gabrielfbdiniz/BMS-Master-STM32-Nucleo-G474RE/README.md

# BMS Master — STM32 Nucleo G474RE (Formula ITA)
### ECU Central de Gerenciamento do Acumulador de Tração (20s18p)

Repositório oficial e unificado (**Monorepo**) de **Hardware**, **Firmware** e **Documentação de Engenharia** do BMS Master desenvolvido para o protótipo Formula SAE Electric da equipe **Formula ITA** (Temporada 2025-2026).

---

## Renderização 3D da Carrier Board

A placa **BMS Master Carrier Shield** é uma PCB de 4 camadas projetada para acoplar o núcleo de processamento **ST NUCLEO-G474RE** via conectores Morpho, integrando circuitos de proteção automotiva, barreira galvânica e interface com o circuito de segurança (SDC).

<div align="center">
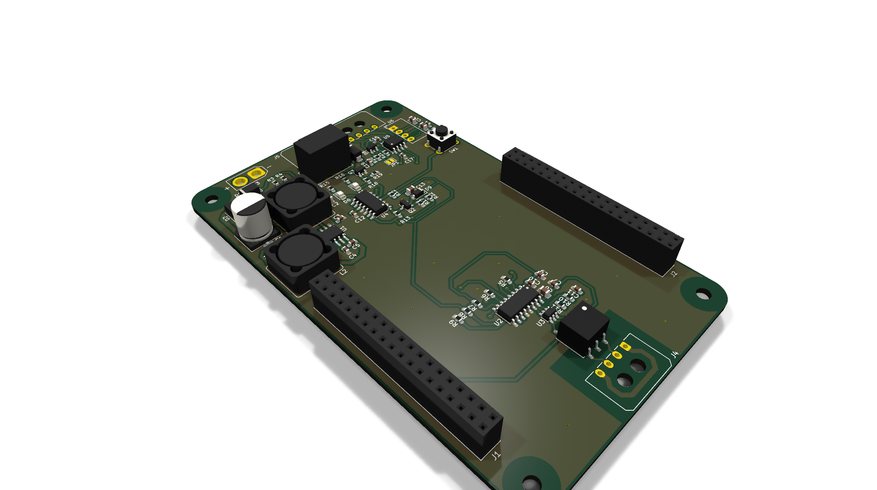
[picture p1: renders/master_render_iso_top.png]
BMS Master Carrier Shield - Perspectiva Superior
  
  <p><em>Vista Isométrica Superior — Destaque para o transformador de pulso Pulse HMU2103NL (Iso-SPI), relé automotivo TE do SDC, regulador buck automotivo e conectores Molex Micro-Fit.</em></p>
</div>

<br>

### Galeria de Vistas 3D (KiCad 10 Raytracing)

| Perspectiva Superior (Iso Top) | Perspectiva Inferior (Iso Bottom) |
| :---: | :---: |
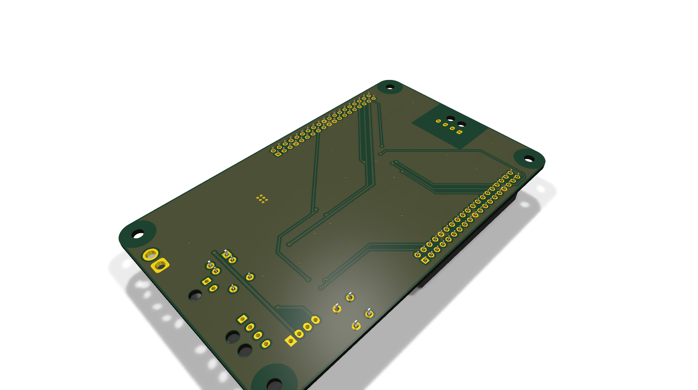
[picture p2: renders/master_render_iso_bottom.png]
Bottom Iso
| Top Iso |  |
| **Vista Ortográfica Superior (Top View)** | **Vista Ortográfica Inferior (Bottom View)** |
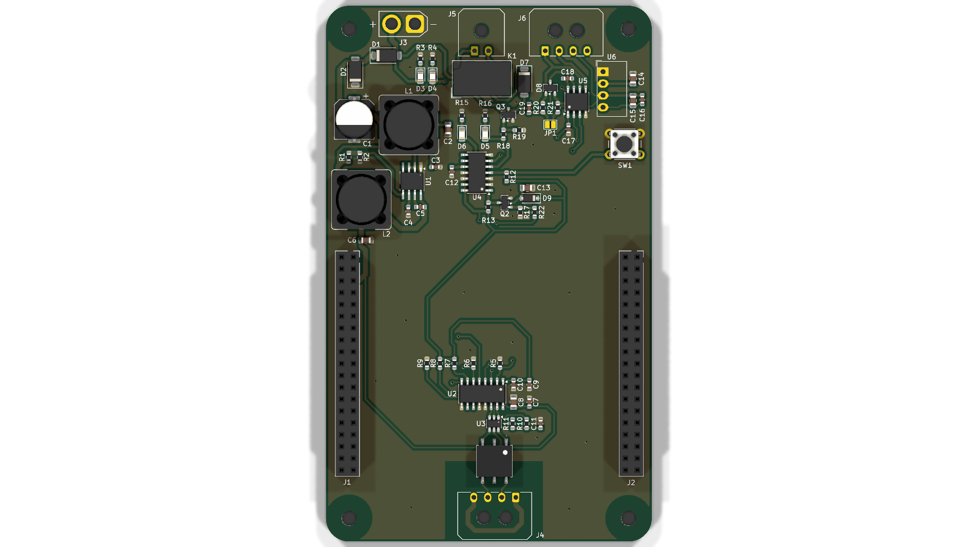
[picture p3: renders/master_render_top.png]
Top Ortho
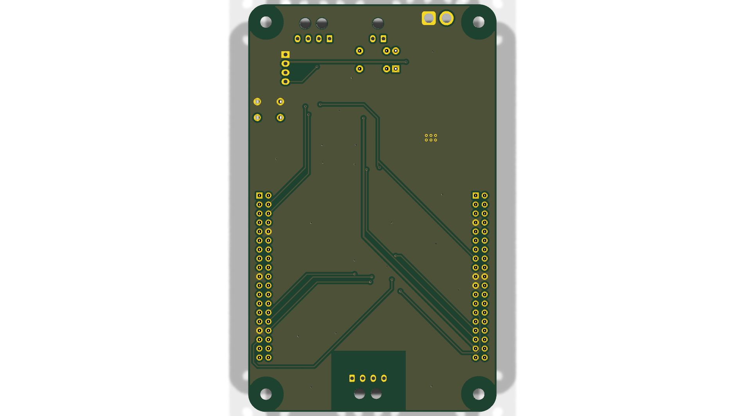
[picture p4: renders/master_render_bottom.png]
Bottom Ortho
|  |  |

---

## Destaques do Projeto de Hardware

* **Topologia do Acumulador:** 20 blocos em série, cada bloco com 18 células em paralelo (**20s18p = 360 células** formato 21700).
* **Processamento Central:** ST NUCLEO-G474RE (MCU ARM Cortex-M4F com FPU a 170 MHz, 512 kB Flash, 128 kB SRAM).
* **Barreira de Isolação Iso-SPI (FSAE EV4.8):** Transceptor ST `L99BM1TR` acoplado a transformador de isolação `Pulse HMU2103NL` ($\ge 2500\text{ V}_{RMS}$, creepage $\ge 4{,}0\text{ mm}$).
* **Interface SDC Hardware Latch:** Circuito biestável puramente em hardware com reset supervisionado, garantindo abertura mandatória da linha de shutdown em qualquer falha crítica.
* **Alimentação e Proteção GLV:** Buck automotivo `TI LMR36510` (12V $\to$ 5V) com supressor TVS SMAJ, diodo Schottky contra inversão de polaridade e filtragem para normas ISO 7637-2.
* **Comunicação Veicular:** CAN-FD isolada galvanicamente via transceptor `TI ISO1042` (suporte a até 5 Mbps).

---

## Estrutura do Repositório (Monorepo)

```text
BMS Master - STM - V0/
├── .gitignore                         # Regras de exclusão Git (KiCad, builds, temporários)
├── README.md                          # Visão geral, especificações e documentação rápida
├── docs/                              # Engenharia de sistemas, especificações e manuais
│   ├── schematics/                    # Esquemáticos oficiais em PDF vetorial
│   │   └── BMS_Master_Schematic.pdf   # Esquemático hierárquico vetorial completo (KiCad 10)
│   ├── PLANO_MESTRE_BMS_MASTER_CONSOLIDADO.md  # Especificação técnica completa do sistema
│   ├── MANUAL_OPERACIONAL_E_MONTAGEM_BMS.md    # Procedimentos de montagem, testes e comissionamento
│   ├── PLANO_DETECCAO_FUSIVEL_METODO_1.md      # Formulação matemática do algoritmo RLS e Z-score
│   ├── GUIA_ENSAIO_CARACTERIZACAO_CELULAS_21700.md # Manual de bancada HPPC (FreedomCAR)
│   └── ARQUITETURA_E_PLANEJAMENTO_BMS_MASTER.md    # Arquitetura conceitual e interfaces
│
├── hardware/                          # Projeto Eletrônico no KiCad 10
│   └── carrier_shield/                # Carrier Board de 4 camadas para NUCLEO-G474RE
│       ├── bms_carrier_shield.kicad_pro  # Projeto mestre KiCad
│       ├── bms_carrier_shield.kicad_sch  # Esquemático mestre
│       ├── bms_carrier_shield.kicad_pcb  # Layout de 4 camadas (Top/GND/PWR/Bot)
│       ├── 01_power_supply.kicad_sch     # Folha: Regulador GLV 12V -> 5V
│       ├── 02_isospi_barrier.kicad_sch   # Folha: Barreira Iso-SPI L99BM1TR + HMU2103NL
│       ├── 03_sdc_latch.kicad_sch        # Folha: Circuito Latch biestável do SDC
│       ├── 05_canfd_interface.kicad_sch  # Folha: Interface CAN-FD isolada ISO1042
│       ├── 06_nucleo_headers.kicad_sch   # Folha: Conectores Morpho NUCLEO-G474RE
│       ├── fp-lib-table, sym-lib-table   # Mapeamento local de bibliotecas
│       ├── libraries/                    # Modelos 3D (.stp/.wrl), símbolos e footprints
│       └── fabrication/                  # Pacote de manufatura e montagem SMT
│           ├── FABRICATION_NOTES.md      # Especificações para fabricação da placa
│           ├── gerbers/                  # Arquivos Gerber RS-274X e Drill Excellon (ZIP)
│           ├── bom/                      # Listas de materiais (CSV, TSV, Mouser, Interactive BOM)
│           └── cpl/                      # Arquivo de posicionamento Pick & Place (pos.csv)
│
├── renders/                           # Renderizações fotorrealistas em alta resolução da PCB (KiCad 10)
│   ├── master_render_iso_top.png
│   ├── master_render_iso_bottom.png
│   ├── master_render_top.png
│   └── master_render_bottom.png
│
├── firmware/                          # Código em C99 Puro (ARM Cortex-M4F & Simulação SIL)
│   ├── core/                          # Algoritmos puros desacoplados de hardware
│   │   ├── bms_types.h                # Definições da topologia 20s18p, limites e telemetria
│   │   ├── alg_fuse_detect.c/.h       # RLS incremental, Z-score e Pre-Flight Check de fusíveis
│   │   ├── alg_soc.c/.h               # Coulomb counting, tabela OCV e limites CCL/DCL dinâmicos
│   │   └── fsm_master.c/.h            # Máquina de estados finitos (FSAE EV4.8 / EV8)
│   ├── mock/                          # Motor de sensoriamento sintético de alta fidelidade
│   ├── tests_sil/                     # Testes de Software-in-the-Loop (SIL) no Host (PC)
│   └── tools/                         # Scripts de simulação e plotagem em Python
│
├── can/                               # Matriz de comunicação veicular CAN-FD
│   ├── README.md                      # Documentação das mensagens CAN e taxas de atualização
│   └── bms_can_matrix.dbc             # Arquivo DBC padronizado
│
└── simulation/                        # Simulação de circuitos analógicos (Proteus VSM)
    └── proteus_sdc_precharge/         # Circuito biestável SDC e transitório RC de pré-carga
```

---

## Software-in-the-Loop (SIL) & Validação de Algoritmos

O firmware foi projetado segundo a arquitetura de **Core Desacoplado**, permitindo que 100% dos algoritmos de segurança, estimativa de estado e detecção de anomalias sejam validados no computador host antes do deployment no microcontrolador:

1. **Detecção de Fusível Rompido via RLS:** Estima recursivamente a resistência interna $\hat{R}_i$ de cada bloco em tempo real durante a descarga ($0{,}833\text{ m}\Omega \to 0{,}882\text{ m}\Omega$, delta de $+49\ \mu\Omega$).
2. **Estimador de SOC Híbrido:** Integração Coulomb Counting compensada por OCV relaxado com limites dinâmicos de corrente de carga (CCL) e descarga (DCL).
3. **FSM Conforme FSAE:** Transições estritas entre `BOOT`, `PRECHARGE`, `DRIVE`, `CHARGING`, `FAULT` e travamento por Latch em caso de violação de envelope seguro.

<div align="center">
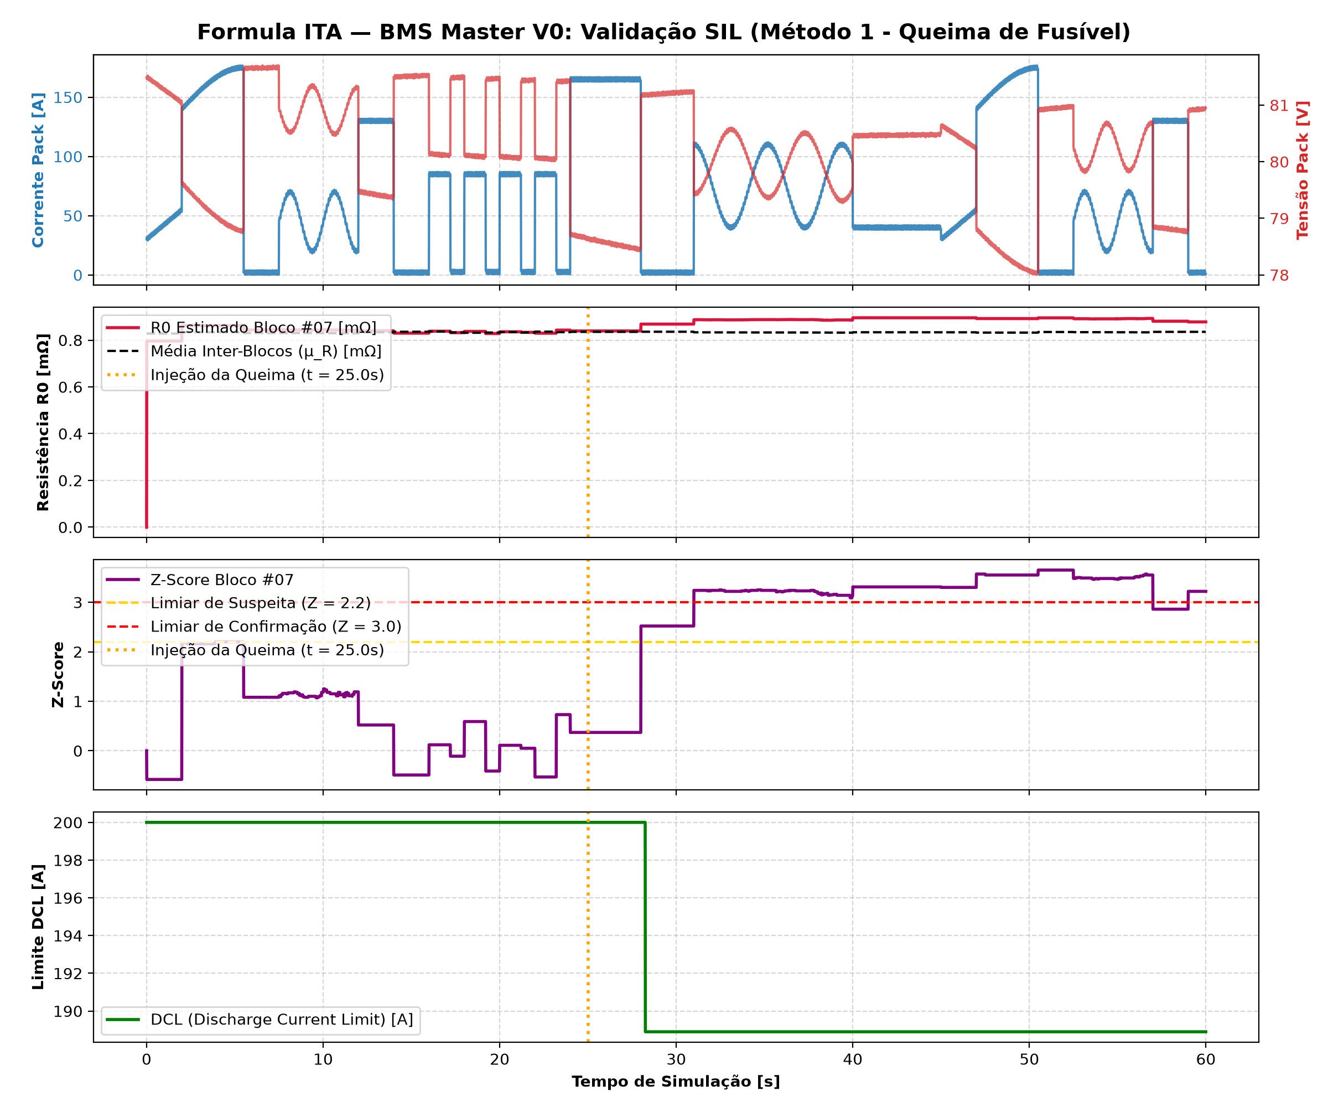
[picture p5: firmware/tests_sil/sil_telemetry_plot.png]
Curvas de Telemetria da Simulação SIL
  
  <p><em>Curvas de resposta dinâmica: Corrente do perfil de corrida, tensões das células, evolução da resistência estimada por RLS com injeção de falha aos 20s e transições de estado da FSM.</em></p>
</div>

### Executando a Simulação SIL Localmente

No terminal, dentro do diretório `firmware/`:

```powershell
# 1. Compilar e rodar a simulação SIL nativa em C (60 segundos virtuais a 100 Hz)
clang -O2 -Wall -Icore -Imock tests_sil/main_sil_runner.c core/alg_fuse_detect.c core/alg_soc.c core/fsm_master.c mock/bms_mock_battery.c mock/drive_cycle.c -o tests_sil/sil_runner.exe -lm
.\tests_sil\sil_runner.exe

# 2. Gerar/atualizar os gráficos de telemetria
python tools/plot_telemetry.py
```

---

## Como Abrir o Projeto Eletrônico no KiCad 10

1. Abra o **KiCad 10**.
2. Selecione **Abrir Projeto** e aponte para:  
   `hardware/carrier_shield/bms_carrier_shield.kicad_pro`.
3. Para visualizar a placa em 3D:
   - Abra o editor de PCB (`bms_carrier_shield.kicad_pcb`).
   - Pressione <kbd>Alt</kbd> + <kbd>3</kbd> para abrir o **Visualizador 3D**.
   - As bibliotecas de modelos (`libraries/3dmodels/`) já estão configuradas relativamente no projeto.
4. Para consultar o esquemático em PDF sem abrir o KiCad:
   - Abra diretamente: [`docs/schematics/BMS_Master_Schematic.pdf`](docs/schematics/BMS_Master_Schematic.pdf).

---

## Documentação Técnica de Referência

Consulte a pasta [`docs/`](docs/) para aprofundamento técnico:
* [**Esquemático Oficial (PDF)**](docs/schematics/BMS_Master_Schematic.pdf) — Desenho esquemático elétrico completo vetorial.
* [**Plano Mestre Consolidado**](docs/PLANO_MESTRE_BMS_MASTER_CONSOLIDADO.md) — Documento mestre de especificação técnica e funcional.
* [**Manual Operacional e de Montagem**](docs/MANUAL_OPERACIONAL_E_MONTAGEM_BMS.md) — Roteiro detalhado de fabricação, montagem de chicotes e testes de bancada.
* [**Plano de Detecção de Fusível Rompido**](docs/PLANO_DETECCAO_FUSIVEL_METODO_1.md) — Formulação matemática do RLS incremental e teste Z-score.
* [**Guia de Caracterização de Células 21700**](docs/GUIA_ENSAIO_CARACTERIZACAO_CELULAS_21700.md) — Protocolo de ensaio experimental HPPC em bancada.

---

<div align="center">
  <sub>Formula ITA — Equipe de Formula SAE Elétrico do Instituto Tecnológico de Aeronáutica (ITA).</sub>
</div>
