gabrielfbdiniz/BMS-Master-STM32-Nucleo-G474RE/hardware/carrier_shield/gerbers/BMS_Carrier_Shield_BOM_Detailed.md

# 📋 Lista Consolidada de Componentes (Bill of Materials - BOM)
## BMS Master Carrier Shield V0 — Formula ITA 2025-2026

| Item | Designador | Qtd | Valor / Componente | Encapsulamento | Fabricante | Código do Fabricante (MPN) | Referência Mouser / LCSC |
| :---: | :---: | :---: | :--- | :--- | :--- | :--- | :--- |
| 1 | `U1` | 1 | **LMR36510ADDA** | HTSOP-8-EP (3.9x4.9mm) | Texas Instruments | `LMR36510ADDAR` | Mouser: 595-LMR36510ADDAR / LCSC: C2682705 |
| 2 | `U2` | 1 | **L99BM1TR** | SOIC-16 (3.9x9.9mm) | STMicroelectronics | `L99BM1TR` | Mouser: 511-L99BM1TR |
| 3 | `U3` | 1 | **USBLC6-2SC6** | SOT-23-6 | STMicroelectronics | `USBLC6-2SC6` | Mouser: 511-USBLC6-2SC6 / LCSC: C7519 |
| 4 | `U4` | 1 | **74HC74** | SOIC-14 (3.9x8.7mm) | Texas Instruments | `SN74HC74DR` | Mouser: 595-SN74HC74DR / LCSC: C5595 |
| 5 | `U5` | 1 | **ISO1044BD** | SOIC-8 (3.9x4.9mm) | Texas Instruments | `ISO1044BDR` | Mouser: 595-ISO1044BDR / LCSC: C711585 |
| 6 | `U6` | 1 | **B0505S-1WR3** | SIP-4 (11.5x6.0mm THT) | Mornsun | `B0505S-1WR3` | LCSC: C148866 / Mouser: 805-B0505S-1WR3 |
| 7 | `T1` | 1 | **HMU2103NL** | SMD-16 (16.2x11.8mm) | Pulse Electronics | `HMU2103NL` | Mouser: 673-HMU2103NL |
| 8 | `K1` | 1 | **G5V-1-DC5** | THT DIP (12.5x7.5mm) | Omron Electronics | `G5V-1-DC5` | Mouser: 653-G5V-1-DC5 / LCSC: C38198 |
| 9 | `Q2` | 1 | **BC817-40** | SOT-23 | Nexperia | `BC817-40,215` | Mouser: 771-BC817-40215 / LCSC: C109033 |
| 10 | `Q3` | 1 | **2N7002** | SOT-23 | Diodes Incorporated | `2N7002-7-F` | Mouser: 621-2N7002-F / LCSC: C8502 |
| 11 | `D1` | 1 | **B340A / SS34** | SMA (DO-214AC) | Diodes Incorporated | `B340A-13-F` | Mouser: 621-B340A-F / LCSC: C15950 |
| 12 | `D2` | 1 | **SMAJ15CA** | SMA (DO-214AC) | Littelfuse | `SMAJ15CA` | Mouser: 576-SMAJ15CA / LCSC: C81747 |
| 13 | `D7` | 1 | **SS14** | SMA (DO-214AC) | Diodes Incorporated | `B140-13-F` | Mouser: 621-B140-F / LCSC: C1577 |
| 14 | `D8` | 1 | **NUP2105L** | SOT-23 | onsemi | `NUP2105LT1G` | Mouser: 863-NUP2105LT1G / LCSC: C14444 |
| 15 | `D3, D4, D5` | 3 | **Green LED** | 0805 (2012 Metric) | Lite-On | `LTST-C170GKT` | Mouser: 859-LTST-C170GKT / LCSC: C72043 |
| 16 | `D6` | 1 | **Red LED** | 0805 (2012 Metric) | Lite-On | `LTST-C170CKT` | Mouser: 859-LTST-C170CKT / LCSC: C72038 |
| 17 | `SW1` | 1 | **PTS645SL43** | 6.0x6.0mm THT H=5.0mm | C&K / Littelfuse | `PTS645SL43-2 LFS` | Mouser: 611-PTS645SL43-2LFS / LCSC: C318884 |
| 18 | `J1, J2` | 2 | **Morpho Female 2x19** | 2.54mm Pitch 2x19 Socket THT | Samtec / Amphenol | `SSW-119-01-T-D` | Mouser: 200-SSW11901TD |
| 19 | `J3` | 1 | **XT30U-F / Micro-Fit 2P** | XT30U-F / Molex 43650-0200 | Amass / Molex | `XT30U-F / 43650-0200` | Mouser: 538-43650-0200 |
| 20 | `J4, J6` | 2 | **Micro-Fit 3.0 4P RA** | Molex 43650-0400 (3.0mm Pitch) | Molex | `0436500400` | Mouser: 538-43650-0400 / LCSC: C2687158 |
| 21 | `J5` | 1 | **Micro-Fit 3.0 2P RA** | Molex 43650-0200 (3.0mm Pitch) | Molex | `0436500200` | Mouser: 538-43650-0200 / LCSC: C2687156 |
| 22 | `L1, L2` | 2 | **10uH 3.5A** | Bourns SRR1260 (12.5x12.5x6.0mm) | Bourns | `SRR1260-100M` | Mouser: 652-SRR1260-100M / LCSC: C108047 |
| 23 | `C1` | 1 | **100uF 35V** | Alum Elec SMD 8.0x10.0mm | Panasonic | `EEE-FK1V101P` | Mouser: 667-EEE-FK1V101P / LCSC: C144131 |
| 24 | `C2, C14, C15` | 3 | **10uF 25V** | 0805 (2012 Metric) | Murata | `GRM21BZ71E106KE15L` | Mouser: 81-GRM21BZ71E106KE5L / LCSC: C15850 |
| 25 | `C6` | 1 | **22uF 16V** | 0805 (2012 Metric) | Murata | `GRM21BR71C226ME15L` | Mouser: 81-GRM21BR71C226ME5L / LCSC: C96927 |
| 26 | `C8` | 1 | **4.7uF 25V** | 0805 (2012 Metric) | Murata | `GRM21BR71E475KA73L` | Mouser: 81-GRM21BR71E475KA3L / LCSC: C19666 |
| 27 | `C4, C10` | 2 | **1uF 25V** | 0603 (1608 Metric) | Murata | `GRM188R71E105KA12D` | Mouser: 81-GRM188R71E105KA2D / LCSC: C15849 |
| 28 | `C3, C5, C7, C9, C12, C16, C17, C18` | 8 | **100nF 50V** | 0603 (1608 Metric) | Yageo / Murata | `CC0603KRX7R9BB104` | Mouser: 603-CC603KRX7R9BB104 / LCSC: C14663 |
| 29 | `C11` | 1 | **10nF 50V** | 0603 (1608 Metric) | Yageo / Murata | `CC0603KRX7R9BB103` | Mouser: 603-CC603KRX7R9BB103 / LCSC: C57112 |
| 30 | `C19` | 1 | **4.7nF 50V** | 0603 (1608 Metric) | Yageo / Murata | `CC0603KRX7R9BB472` | Mouser: 603-CC603KRX7R9BB472 / LCSC: C57114 |
| 31 | `R1, R19` | 2 | **100k 1%** | 0603 (1608 Metric) | Yageo | `RC0603FR-07100KL` | Mouser: 603-RC0603FR-07100KL / LCSC: C25804 |
| 32 | `R2` | 1 | **24.9k 1%** | 0603 (1608 Metric) | Yageo | `RC0603FR-0724K9L` | Mouser: 603-RC0603FR-0724K9L / LCSC: C23171 |
| 33 | `R3, R4, R15, R16, R22` | 5 | **1k 1%** | 0603 (1608 Metric) | Yageo | `RC0603FR-071KL` | Mouser: 603-RC0603FR-071KL / LCSC: C21190 |
| 34 | `R5` | 1 | **47k 1%** | 0603 (1608 Metric) | Yageo | `RC0603FR-0747KL` | Mouser: 603-RC0603FR-0747KL / LCSC: C25817 |
| 35 | `R6, R7, R8, R9, R12, R13, R17` | 7 | **10k 1%** | 0603 (1608 Metric) | Yageo | `RC0603FR-0710KL` | Mouser: 603-RC0603FR-0710KL / LCSC: C25804 |
| 36 | `R10, R11, R20, R21` | 4 | **60.4 1%** | 0603 (1608 Metric) | Yageo | `RC0603FR-0760R4L` | Mouser: 603-RC0603FR-0760R4L / LCSC: C23238 |
| 37 | `R18` | 1 | **100 1%** | 0603 (1608 Metric) | Yageo | `RC0603FR-07100RL` | Mouser: 603-RC0603FR-07100RL / LCSC: C22775 |
