gabrielfbdiniz/BMS-Master-STM32-Nucleo-G474RE/hardware/carrier_shield/fabrication/bom/bms_carrier_shield-bom.csv

Refs | Value | Footprint | Qty | DNP
C1 | 100u | Capacitor_SMD:CP_Elec_8x10 | 1
C2 | 10u | Capacitor_SMD:C_0805_2012Metric_Pad1.18x1.45mm_HandSolder | 1
C3 | 100n | Capacitor_SMD:C_0603_1608Metric_Pad1.08x0.95mm_HandSolder | 1
C4 | 1u | Capacitor_SMD:C_0603_1608Metric_Pad1.08x0.95mm_HandSolder | 1
C5 | 100n | Capacitor_SMD:C_0603_1608Metric_Pad1.08x0.95mm_HandSolder | 1
C6 | 22u | Capacitor_SMD:C_0805_2012Metric_Pad1.18x1.45mm_HandSolder | 1
C7 | 100n | Capacitor_SMD:C_0603_1608Metric_Pad1.08x0.95mm_HandSolder | 1
C8 | 4u7 | Capacitor_SMD:C_0805_2012Metric_Pad1.18x1.45mm_HandSolder | 1
C9 | 100n | Capacitor_SMD:C_0603_1608Metric_Pad1.08x0.95mm_HandSolder | 1
C10 | 1u | Capacitor_SMD:C_0603_1608Metric_Pad1.08x0.95mm_HandSolder | 1
C11 | 10n | Capacitor_SMD:C_0603_1608Metric_Pad1.08x0.95mm_HandSolder | 1
C12 | 100n | Capacitor_SMD:C_0603_1608Metric_Pad1.08x0.95mm_HandSolder | 1
C14 | 10u | Capacitor_SMD:C_0805_2012Metric_Pad1.18x1.45mm_HandSolder | 1
C15 | 10u | Capacitor_SMD:C_0805_2012Metric_Pad1.18x1.45mm_HandSolder | 1
C16 | 100n | Capacitor_SMD:C_0603_1608Metric_Pad1.08x0.95mm_HandSolder | 1
C17 | 100n | Capacitor_SMD:C_0603_1608Metric_Pad1.08x0.95mm_HandSolder | 1
C18 | 100n | Capacitor_SMD:C_0603_1608Metric_Pad1.08x0.95mm_HandSolder | 1
C19 | 4n7 | Capacitor_SMD:C_0603_1608Metric_Pad1.08x0.95mm_HandSolder | 1
D1 | D_Schottky | Diode_SMD:D_SMA | 1
D2 | D_TVS | Diode_SMD:D_SMA | 1
D3 | 12V | LED_SMD:LED_0805_2012Metric_Pad1.15x1.40mm_HandSolder | 1
D4 | 5V | LED_SMD:LED_0805_2012Metric_Pad1.15x1.40mm_HandSolder | 1
D5 | SDC OK | LED_SMD:LED_0805_2012Metric_Pad1.15x1.40mm_HandSolder | 1
D6 | AMS FAULT | LED_SMD:LED_0805_2012Metric_Pad1.15x1.40mm_HandSolder | 1
D7 | SS14 | Diode_SMD:D_SMA | 1
D8 | NUP2105L | Package_TO_SOT_SMD:SOT-23 | 1
J1 | Conn_02x19_Odd_Even | Connector_PinSocket_2.54mm:PinSocket_2x19_P2.54mm_Vertical | 1
J2 | Conn_02x19_Odd_Even | Connector_PinSocket_2.54mm:PinSocket_2x19_P2.54mm_Vertical | 1
J3 | GLV 12V | Connector_AMASS:AMASS_XT30U-F_1x02_P5.0mm_Vertical | 1
J4 | Conn_01x04 | Connector_Molex:Molex_Micro-Fit_3.0_43650-0400_1x04_P3.00mm_Horizontal | 1
J5 | Conn_01x02 | Connector_Molex:Molex_Micro-Fit_3.0_43650-0200_1x02_P3.00mm_Horizontal | 1
J6 | Conn_01x04 | Connector_Molex:Molex_Micro-Fit_3.0_43650-0400_1x04_P3.00mm_Horizontal | 1
K1 | G5V-1 | Relay_THT:Relay_SPDT_Omron_G5V-1 | 1
L1 | 10u | Inductor_SMD:L_Bourns_SRR1260 | 1
L2 | L | Inductor_SMD:L_Bourns_SRR1260 | 1
Q2 | BC817 | Package_TO_SOT_SMD:SOT-23 | 1
Q3 | 2N7002 | Package_TO_SOT_SMD:SOT-23 | 1
R1 | 100k | Resistor_SMD:R_0603_1608Metric_Pad0.98x0.95mm_HandSolder | 1
R2 | 24k9 | Resistor_SMD:R_0603_1608Metric_Pad0.98x0.95mm_HandSolder | 1
R3 | 1k | Resistor_SMD:R_0603_1608Metric_Pad0.98x0.95mm_HandSolder | 1
R4 | 1k | Resistor_SMD:R_0603_1608Metric_Pad0.98x0.95mm_HandSolder | 1
R5 | 47k | Resistor_SMD:R_0603_1608Metric_Pad0.98x0.95mm_HandSolder | 1
R6 | 10k | Resistor_SMD:R_0603_1608Metric_Pad0.98x0.95mm_HandSolder | 1
R7 | 10k | Resistor_SMD:R_0603_1608Metric_Pad0.98x0.95mm_HandSolder | 1
R8 | 10k | Resistor_SMD:R_0603_1608Metric_Pad0.98x0.95mm_HandSolder | 1
R9 | 10k | Resistor_SMD:R_0603_1608Metric_Pad0.98x0.95mm_HandSolder | 1
R10 | 60.4 | Resistor_SMD:R_0603_1608Metric_Pad0.98x0.95mm_HandSolder | 1
R11 | 60.4 | Resistor_SMD:R_0603_1608Metric_Pad0.98x0.95mm_HandSolder | 1
R12 | 10k | Resistor_SMD:R_0603_1608Metric_Pad0.98x0.95mm_HandSolder | 1
R13 | 10k | Resistor_SMD:R_0603_1608Metric_Pad0.98x0.95mm_HandSolder | 1
R15 | 1k | Resistor_SMD:R_0603_1608Metric_Pad0.98x0.95mm_HandSolder | 1
R16 | 1k | Resistor_SMD:R_0603_1608Metric_Pad0.98x0.95mm_HandSolder | 1
R17 | 10k | Resistor_SMD:R_0603_1608Metric_Pad0.98x0.95mm_HandSolder | 1
R18 | 100 | Resistor_SMD:R_0603_1608Metric_Pad0.98x0.95mm_HandSolder | 1
R19 | 100k | Resistor_SMD:R_0603_1608Metric_Pad0.98x0.95mm_HandSolder | 1
R20 | 60.4 | Resistor_SMD:R_0603_1608Metric_Pad0.98x0.95mm_HandSolder | 1
R21 | 60.4 | Resistor_SMD:R_0603_1608Metric_Pad0.98x0.95mm_HandSolder | 1
R22 | 1k | Resistor_SMD:R_0603_1608Metric_Pad0.98x0.95mm_HandSolder | 1
SW1 | SW_Push | Button_Switch_THT:SW_PUSH_6mm_H5mm | 1
T1 | HMU2103NL | HMU2103NL:HMU2103NL | 1
U1 | LMR36510ADDA | Package_SO:Texas_HTSOP-8-1EP_3.9x4.9mm_P1.27mm_EP2.95x4.9mm_Mask2.4x3.1mm_ThermalVias | 1
U2 | L99BM1TR | Package_SO:SOIC-16_3.9x9.9mm_P1.27mm | 1
U3 | USBLC6-2SC6 | Package_TO_SOT_SMD:SOT-23-6 | 1
U4 | 74HC74 | Package_SO:SOIC-14_3.9x8.7mm_P1.27mm | 1
U5 | ISO1044BD | Package_SO:SOIC-8_3.9x4.9mm_P1.27mm | 1
U6 | B0505S-1WR3 | Converter_DCDC:Converter_DCDC_Murata_MEE1SxxxxSC_THT | 1
