gabrielfbdiniz/BMS-Master-STM32-Nucleo-G474RE/firmware/tests_sil/sil_telemetry_log.csv

time_s | current_a | pack_v | soc_pct | fsm_state | dcl_a | mean_r0_mohm | std_r0_uohm | b07_r0_mohm | b07_z | b07_status | b07_active_cells
0.000 | 29.92 | 81.49 | 90.00 | 1 | 200.0 | 0.8282 | 54.77 | 0.0000 | 0.00 | 0 | 0
0.010 | 31.35 | 81.48 | 90.00 | 2 | 200.0 | 0.8282 | 54.77 | 0.7963 | -0.58 | 0 | 18
0.020 | 31.76 | 81.46 | 90.00 | 2 | 200.0 | 0.8282 | 54.77 | 0.7963 | -0.58 | 0 | 18
0.030 | 32.05 | 81.47 | 90.00 | 2 | 200.0 | 0.8282 | 54.77 | 0.7963 | -0.58 | 0 | 18
0.040 | 31.76 | 81.48 | 90.00 | 2 | 200.0 | 0.8282 | 54.77 | 0.7963 | -0.58 | 0 | 18
0.050 | 30.52 | 81.48 | 90.00 | 2 | 200.0 | 0.8282 | 54.77 | 0.7963 | -0.58 | 0 | 18
0.060 | 29.71 | 81.51 | 90.00 | 2 | 200.0 | 0.8282 | 54.77 | 0.7963 | -0.58 | 0 | 18
0.070 | 29.04 | 81.52 | 90.00 | 2 | 200.0 | 0.8282 | 54.77 | 0.7963 | -0.58 | 0 | 18
0.080 | 29.45 | 81.50 | 90.00 | 2 | 200.0 | 0.8282 | 54.77 | 0.7963 | -0.58 | 0 | 18
0.090 | 30.26 | 81.50 | 90.00 | 2 | 200.0 | 0.8282 | 54.77 | 0.7963 | -0.58 | 0 | 18
0.100 | 31.35 | 81.48 | 90.00 | 2 | 200.0 | 0.8282 | 54.77 | 0.7963 | -0.58 | 0 | 18
0.110 | 32.34 | 81.46 | 90.00 | 2 | 200.0 | 0.8282 | 54.77 | 0.7963 | -0.58 | 0 | 18
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
