gabrielfbdiniz/BMS-Master-STM32-Nucleo-G474RE/hardware/carrier_shield/bms_carrier_shield.kicad_pcb

## KiCad design hardware/carrier_shield/bms_carrier_shield.kicad_pcb (2026-11-01)

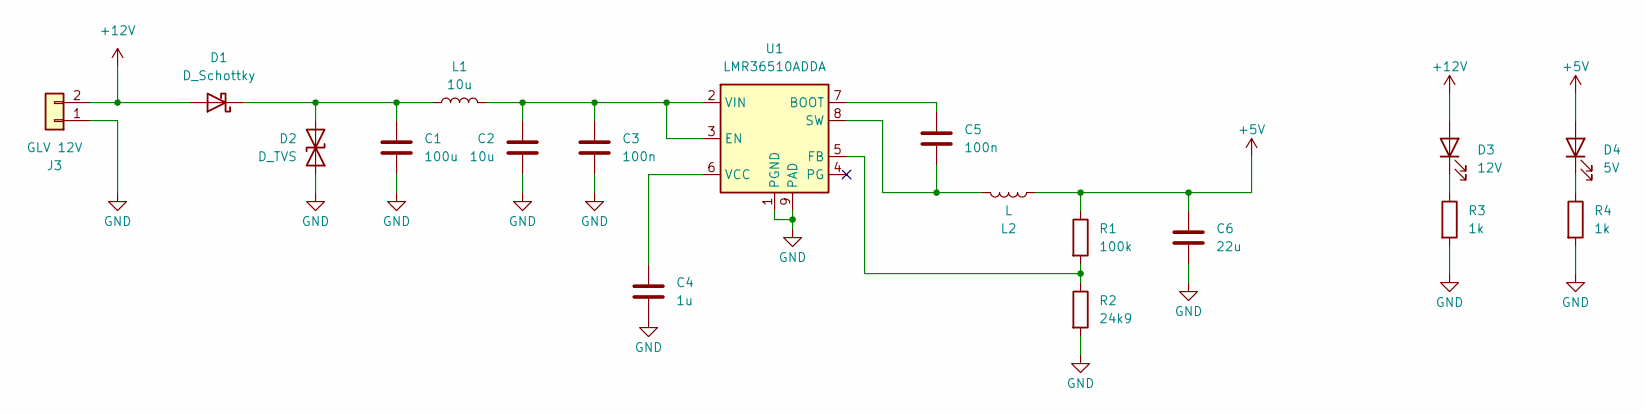
[picture p12: schematic 01_power_supply.kicad_sch, Bloco 01 — Regulador Automotivo GLV 12V -> 5V (ISO 7637-2)]

Parts:
C1: 100u; CP_Elec_8x10
C2: 10u; C_0805_2012Metric_Pad1.18x1.45mm_HandSolder
C3, C5: 100n; C_0603_1608Metric_Pad1.08x0.95mm_HandSolder
C4: 1u; C_0603_1608Metric_Pad1.08x0.95mm_HandSolder
C6: 22u; C_0805_2012Metric_Pad1.18x1.45mm_HandSolder
D1: D_Schottky; D_SMA
D2: D_TVS; D_SMA
D3: 12V; LED_0805_2012Metric_Pad1.15x1.40mm_HandSolder
D4: 5V; LED_0805_2012Metric_Pad1.15x1.40mm_HandSolder
J3: GLV 12V; AMASS_XT30U-F_1x02_P5.0mm_Vertical
L1: 10u; L_Bourns_SRR1260
L2: L; L_Bourns_SRR1260
R1: 100k; R_0603_1608Metric_Pad0.98x0.95mm_HandSolder
R2: 24k9; R_0603_1608Metric_Pad0.98x0.95mm_HandSolder
R3, R4: 1k; R_0603_1608Metric_Pad0.98x0.95mm_HandSolder
U1: LMR36510ADDA; Texas_HTSOP-8-1EP_3.9x4.9mm_P1.27mm_EP2.95x4.9mm_Mask2.4x3.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

Connections:
+5V: C6.1, D4.2 (A), L2.2, R1.1; also elsewhere on the board
+12V: D1.2 (A), D3.2 (A), J3.2; also elsewhere on the board
GND: C1.2, C2.2, C3.2, C4.2, C6.2, D2.1 (A1), J3.1, R2.2, R3.2, R4.2, U1.1 (PGND), U1.9 (PAD); also elsewhere on the board
unnamed: C1.1, D1.1 (K), D2.2 (A2), L1.1
unnamed: D3.1 (K), R3.1
unnamed: D4.1 (K), R4.1
unnamed: C5.1, U1.7 (BOOT)
unnamed: C2.1, C3.1, L1.2, U1.2 (VIN), U1.3 (EN)
unnamed: R1.2, R2.1, U1.5 (FB)
unnamed: C5.2, L2.1, U1.8 (SW)
unnamed: C4.1, U1.6 (VCC)

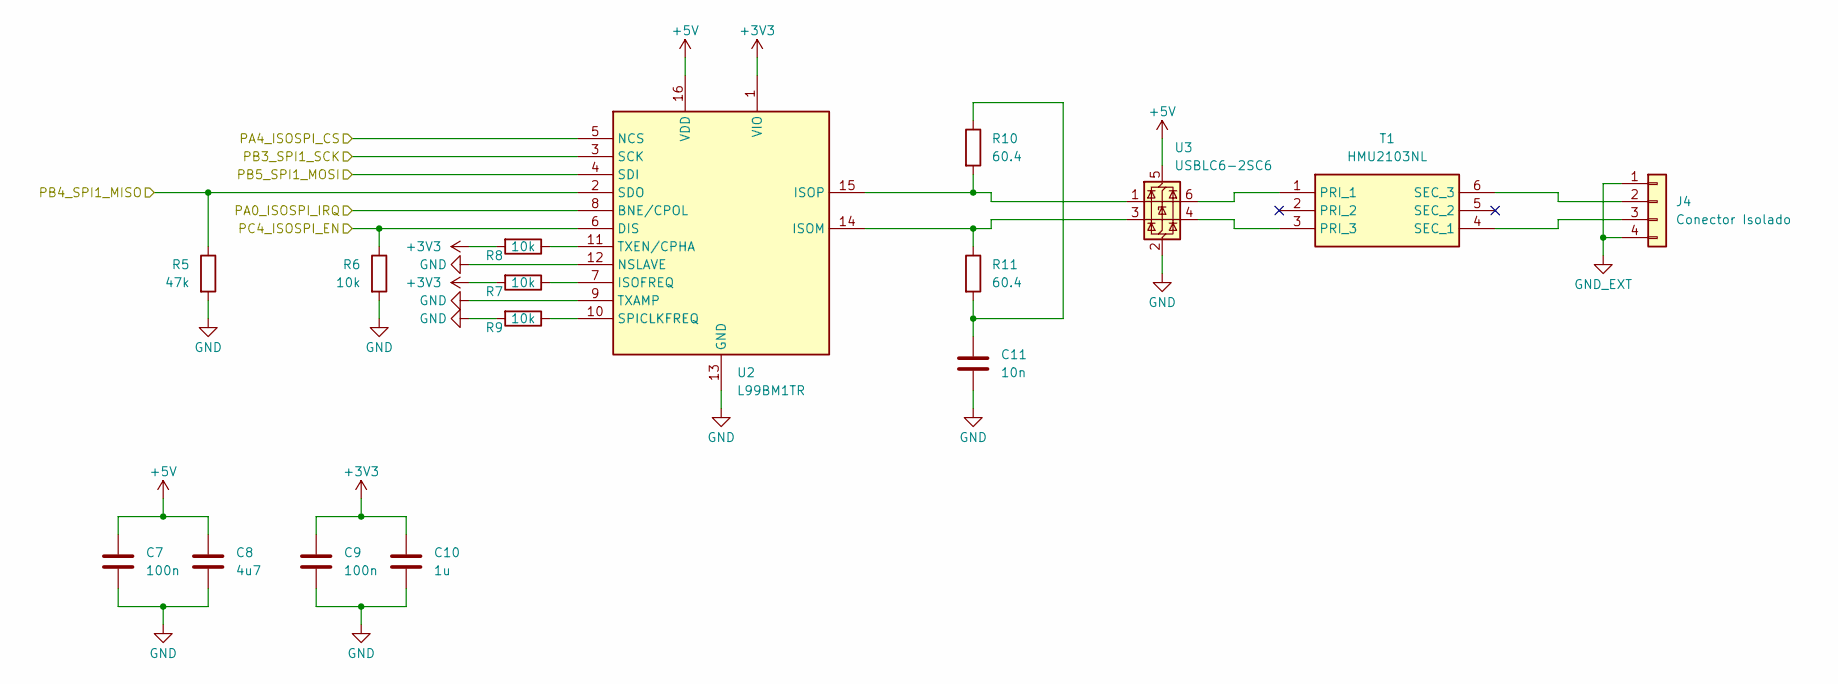
[picture p13: schematic 02_isospi_barrier.kicad_sch, Bloco 02 — Subsistema Iso-SPI com Barreira Galvânica 2500V]

Parts:
C7, C9: 100n; C_0603_1608Metric_Pad1.08x0.95mm_HandSolder
C8: 4u7; C_0805_2012Metric_Pad1.18x1.45mm_HandSolder
C10: 1u; C_0603_1608Metric_Pad1.08x0.95mm_HandSolder
C11: 10n; C_0603_1608Metric_Pad1.08x0.95mm_HandSolder
J4: Conector Isolado; Molex_Micro-Fit_3.0_43650-0400_1x04_P3.00mm_Horizontal
R5: 47k; R_0603_1608Metric_Pad0.98x0.95mm_HandSolder
R6, R7, R8, R9: 10k; R_0603_1608Metric_Pad0.98x0.95mm_HandSolder
R10, R11: 60.4; R_0603_1608Metric_Pad0.98x0.95mm_HandSolder
T1: HMU2103NL; Mouser Part Number 673-HMU2103NL
U2: L99BM1TR; SOIC-16_3.9x9.9mm_P1.27mm; Manufacturer_Part_Number L99BM1TR
U3: USBLC6-2SC6; SOT-23-6

Connections:
+3V3: C9.1, C10.1, R7.2, R8.2, U2.1 (VIO); also elsewhere on the board
+5V: C7.1, C8.1, U2.16 (VDD), U3.5 (VBUS); also elsewhere on the board
/05_Nucleo_G474RE_Morpho_Headers/PA0_ISOSPI_IRQ: U2.8 (BNE/CPOL); also elsewhere on the board
/05_Nucleo_G474RE_Morpho_Headers/PA4_ISOSPI_CS: U2.5 (NCS); also elsewhere on the board
/05_Nucleo_G474RE_Morpho_Headers/PB3_SPI1_SCK: U2.3 (SCK); also elsewhere on the board
/05_Nucleo_G474RE_Morpho_Headers/PB4_SPI1_MISO: R5.1, U2.2 (SDO); also elsewhere on the board
/05_Nucleo_G474RE_Morpho_Headers/PB5_SPI1_MOSI: U2.4 (SDI); also elsewhere on the board
/05_Nucleo_G474RE_Morpho_Headers/PC4_ISOSPI_EN: R6.1, U2.6 (DIS); also elsewhere on the board
GND: C7.2, C8.2, C9.2, C10.2, C11.2, R5.2, R6.2, R9.2, U2.9 (TXAMP), U2.12 (NSLAVE), U2.13 (GND), U3.2 (GND); also elsewhere on the board
GND_EXT: J4.1, J4.4
unnamed: C11.1, R10.1, R11.2
unnamed: J4.2, T1.6 (SEC_3)
unnamed: J4.3, T1.4 (SEC_1)
unnamed: T1.1 (PRI_1), U3.6 (I/O1)
unnamed: T1.3 (PRI_3), U3.4 (I/O2)
unnamed: R7.1, U2.7 (ISOFREQ)
unnamed: R11.1, U2.14 (ISOM), U3.3 (I/O2)
unnamed: R10.2, U2.15 (ISOP), U3.1 (I/O1)
unnamed: R9.1, U2.10 (SPICLKFREQ)
unnamed: R8.1, U2.11 (TXEN/CPHA)

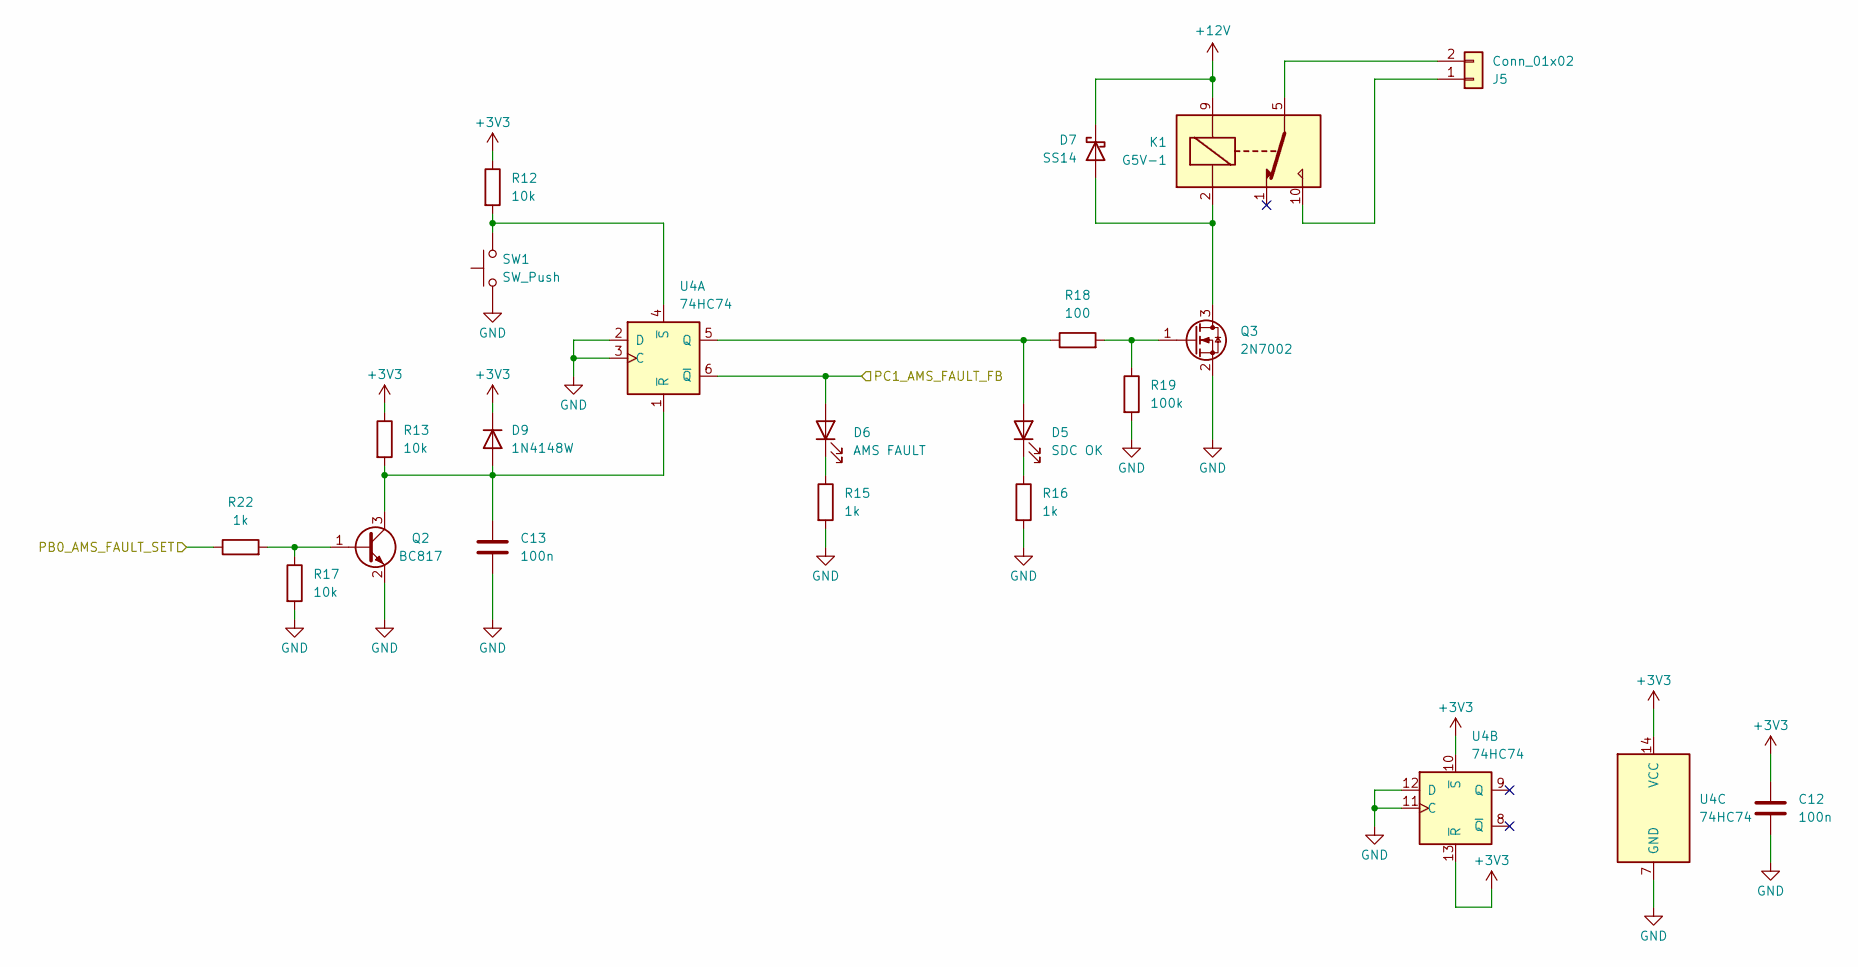
[picture p14: schematic 03_sdc_latch.kicad_sch, Bloco 03 — Circuito Latch de Falha AMS & Relé SDC (FSAE EV4…]

Parts:
C12: 100n; C_0603_1608Metric_Pad1.08x0.95mm_HandSolder
C13: 100n
D5: SDC OK; LED_0805_2012Metric_Pad1.15x1.40mm_HandSolder
D6: AMS FAULT; LED_0805_2012Metric_Pad1.15x1.40mm_HandSolder
D7: SS14; D_SMA
D9: 1N4148W; D_SOD-123
J5: Conn_01x02; Molex_Micro-Fit_3.0_43650-0200_1x02_P3.00mm_Horizontal
K1: G5V-1; Relay_SPDT_Omron_G5V-1
Q2: BC817; SOT-23
Q3: 2N7002; SOT-23
R12, R13, R17: 10k; R_0603_1608Metric_Pad0.98x0.95mm_HandSolder
R15, R16, R22: 1k; R_0603_1608Metric_Pad0.98x0.95mm_HandSolder
R18: 100; R_0603_1608Metric_Pad0.98x0.95mm_HandSolder
R19: 100k; R_0603_1608Metric_Pad0.98x0.95mm_HandSolder
SW1: SW_Push; SW_PUSH_6mm_H5mm
U4: 74HC74; SOIC-14_3.9x8.7mm_P1.27mm

Connections:
+3V3: C12.1, D9.1 (K), R12.1, R13.1, U4.10 (~S), U4.13 (~R), U4.14 (VCC); also elsewhere on the board
+12V: D7.1 (K), K1.9; also elsewhere on the board
/05_Nucleo_G474RE_Morpho_Headers/PB0_AMS_FAULT_SET: R22.1; also elsewhere on the board
/05_Nucleo_G474RE_Morpho_Headers/PC1_AMS_FAULT_FB: D6.2 (A), U4.6 (~Q); also elsewhere on the board
GND: C12.2, C13.2, Q2.2 (E), Q3.2 (S), R15.2, R16.2, R17.2, R19.2, SW1.1, U4.2 (D), U4.3 (C), U4.7 (GND), U4.11 (C), U4.12 (D); also elsewhere on the board
unnamed: D5.2 (A), R18.1, U4.5 (Q)
unnamed: D5.1 (K), R16.1
unnamed: D6.1 (K), R15.1
unnamed: D7.2 (A), K1.2, Q3.3 (D)
unnamed: C13.1, D9.2 (A), Q2.3 (C), R13.2, U4.1 (~R)
unnamed: J5.1, K1.10
unnamed: J5.2, K1.5, K1.6
unnamed: Q2.1 (B), R17.1, R22.2
unnamed: Q3.1 (G), R18.2, R19.1
unnamed: R12.2, SW1.2, U4.4 (~S)

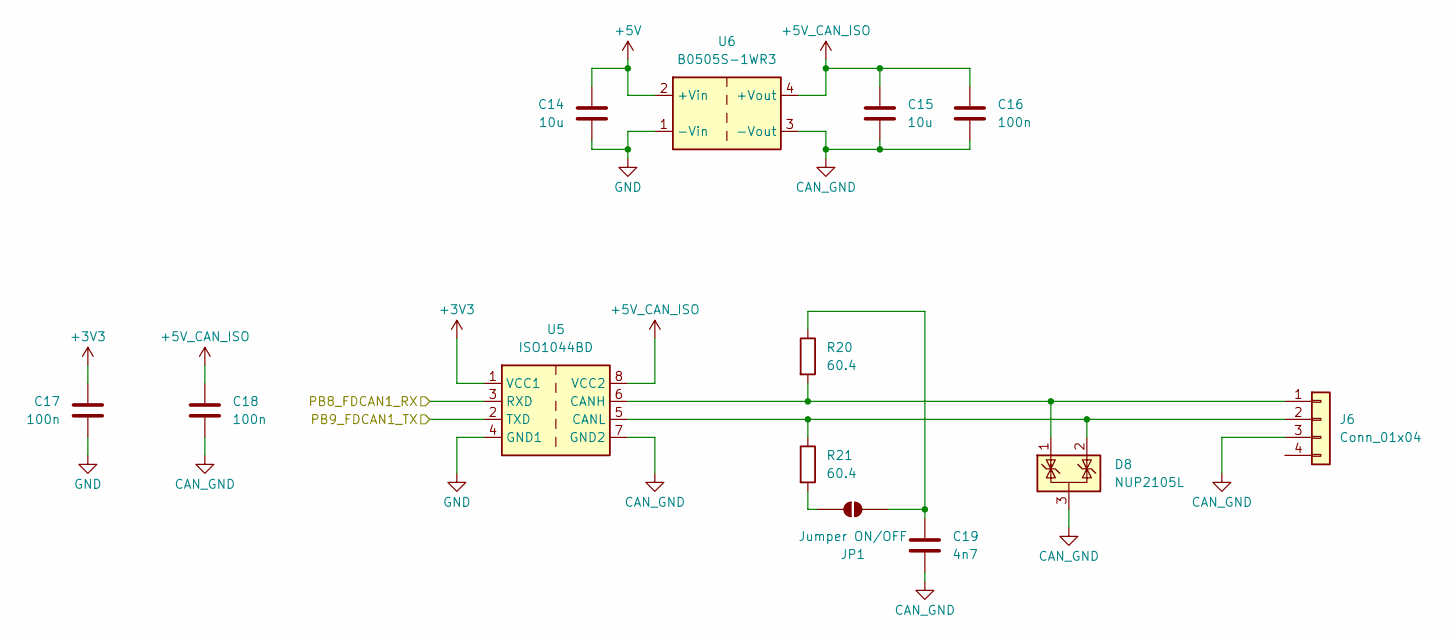
[picture p15: schematic 05_canfd_interface.kicad_sch, Bloco 05 — Transceptor FDCAN Isolado e Barramento Veicular]

Parts:
C14, C15: 10u; C_0805_2012Metric_Pad1.18x1.45mm_HandSolder
C16, C17, C18: 100n; C_0603_1608Metric_Pad1.08x0.95mm_HandSolder
C19: 4n7; C_0603_1608Metric_Pad1.08x0.95mm_HandSolder
D8: NUP2105L; SOT-23
J6: Conn_01x04; Molex_Micro-Fit_3.0_43650-0400_1x04_P3.00mm_Horizontal
JP1: Jumper ON/OFF; SolderJumper-2_P1.3mm_Open_Pad1.0x1.5mm
R20, R21: 60.4; R_0603_1608Metric_Pad0.98x0.95mm_HandSolder
U5: ISO1044BD; SOIC-8_3.9x4.9mm_P1.27mm
U6: B0505S-1WR3; Converter_DCDC_Murata_MEE1SxxxxSC_THT

Connections:
+3V3: C17.1, U5.1 (VCC1); also elsewhere on the board
+5V: C14.1, U6.2 (+Vin); also elsewhere on the board
+5V_CAN_ISO: C15.1, C16.1, C18.1, U5.8 (VCC2), U6.4 (+Vout)
/05_Nucleo_G474RE_Morpho_Headers/PB8_FDCAN1_RX: U5.2 (TXD); also elsewhere on the board
/05_Nucleo_G474RE_Morpho_Headers/PB9_FDCAN1_TX: U5.3 (RXD); also elsewhere on the board
CAN_GND: C15.2, C16.2, C18.2, C19.2, D8.3 (A), J6.3, U5.7 (GND2), U6.3 (-Vout)
GND: C14.2, C17.2, U5.4 (GND1), U6.1 (-Vin); also elsewhere on the board
unnamed: D8.1 (K), J6.1, R20.2, U5.6 (CANH)
unnamed: D8.2 (K), J6.2, R21.1, U5.5 (CANL)
unnamed: JP1.1 (A), R21.2
unnamed: C19.1, JP1.2 (B), R20.1

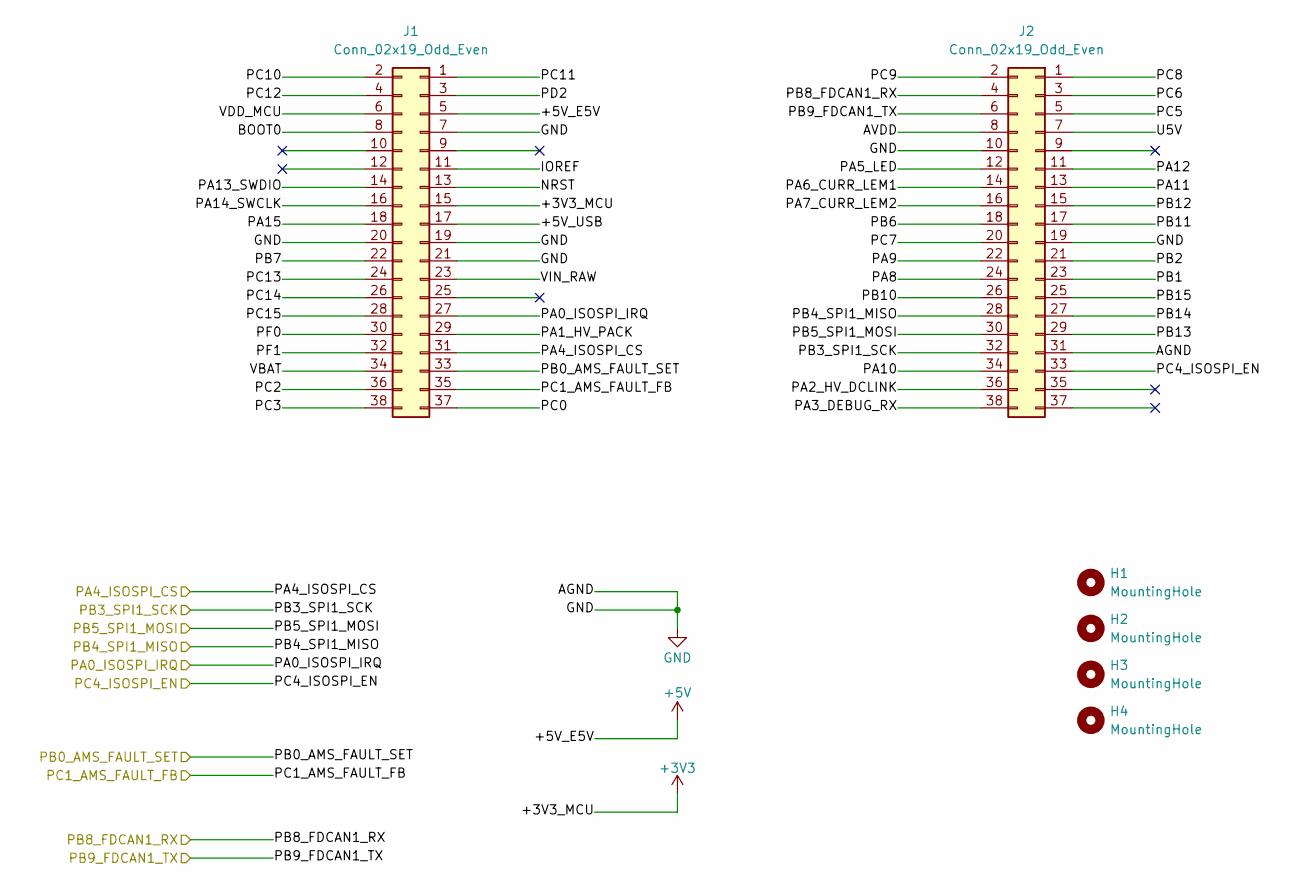
[picture p16: schematic 06_nucleo_headers.kicad_sch, Bloco 06 — Headers Morpho ST CN7 e CN10 (NUCLEO-G474RE)]

Parts:
H1, H2, H3, H4: MountingHole; MountingHole_3.2mm_M3
J1, J2: Conn_02x19_Odd_Even; PinSocket_2x19_P2.54mm_Vertical

Connections:
+3V3: J1.15; also elsewhere on the board
+5V: J1.5; also elsewhere on the board
/05_Nucleo_G474RE_Morpho_Headers/+5V_USB: J1.17
/05_Nucleo_G474RE_Morpho_Headers/AVDD: J2.8
/05_Nucleo_G474RE_Morpho_Headers/BOOT0: J1.8
/05_Nucleo_G474RE_Morpho_Headers/IOREF: J1.11
/05_Nucleo_G474RE_Morpho_Headers/NRST: J1.13
/05_Nucleo_G474RE_Morpho_Headers/PA0_ISOSPI_IRQ: J1.27; also elsewhere on the board
/05_Nucleo_G474RE_Morpho_Headers/PA1_HV_PACK: J1.29
/05_Nucleo_G474RE_Morpho_Headers/PA2_HV_DCLINK: J2.36
/05_Nucleo_G474RE_Morpho_Headers/PA3_DEBUG_RX: J2.38
/05_Nucleo_G474RE_Morpho_Headers/PA4_ISOSPI_CS: J1.31; also elsewhere on the board
/05_Nucleo_G474RE_Morpho_Headers/PA5_LED: J2.12
/05_Nucleo_G474RE_Morpho_Headers/PA6_CURR_LEM1: J2.14
/05_Nucleo_G474RE_Morpho_Headers/PA7_CURR_LEM2: J2.16
/05_Nucleo_G474RE_Morpho_Headers/PA8: J2.24
/05_Nucleo_G474RE_Morpho_Headers/PA9: J2.22
/05_Nucleo_G474RE_Morpho_Headers/PA10: J2.34
/05_Nucleo_G474RE_Morpho_Headers/PA11: J2.13
/05_Nucleo_G474RE_Morpho_Headers/PA12: J2.11
/05_Nucleo_G474RE_Morpho_Headers/PA13_SWDIO: J1.14
/05_Nucleo_G474RE_Morpho_Headers/PA14_SWCLK: J1.16
/05_Nucleo_G474RE_Morpho_Headers/PA15: J1.18
/05_Nucleo_G474RE_Morpho_Headers/PB0_AMS_FAULT_SET: J1.33; also elsewhere on the board
/05_Nucleo_G474RE_Morpho_Headers/PB1: J2.23
/05_Nucleo_G474RE_Morpho_Headers/PB2: J2.21
/05_Nucleo_G474RE_Morpho_Headers/PB3_SPI1_SCK: J2.32; also elsewhere on the board
/05_Nucleo_G474RE_Morpho_Headers/PB4_SPI1_MISO: J2.28; also elsewhere on the board
/05_Nucleo_G474RE_Morpho_Headers/PB5_SPI1_MOSI: J2.30; also elsewhere on the board
/05_Nucleo_G474RE_Morpho_Headers/PB6: J2.18
/05_Nucleo_G474RE_Morpho_Headers/PB7: J1.22
/05_Nucleo_G474RE_Morpho_Headers/PB8_FDCAN1_RX: J2.4; also elsewhere on the board
/05_Nucleo_G474RE_Morpho_Headers/PB9_FDCAN1_TX: J2.6; also elsewhere on the board
/05_Nucleo_G474RE_Morpho_Headers/PB10: J2.26
/05_Nucleo_G474RE_Morpho_Headers/PB11: J2.17
/05_Nucleo_G474RE_Morpho_Headers/PB12: J2.15
/05_Nucleo_G474RE_Morpho_Headers/PB13: J2.29
/05_Nucleo_G474RE_Morpho_Headers/PB14: J2.27
/05_Nucleo_G474RE_Morpho_Headers/PB15: J2.25
/05_Nucleo_G474RE_Morpho_Headers/PC0: J1.37
/05_Nucleo_G474RE_Morpho_Headers/PC1_AMS_FAULT_FB: J1.35; also elsewhere on the board
/05_Nucleo_G474RE_Morpho_Headers/PC2: J1.36
/05_Nucleo_G474RE_Morpho_Headers/PC3: J1.38
/05_Nucleo_G474RE_Morpho_Headers/PC4_ISOSPI_EN: J2.33; also elsewhere on the board
/05_Nucleo_G474RE_Morpho_Headers/PC5: J2.5
/05_Nucleo_G474RE_Morpho_Headers/PC6: J2.3
/05_Nucleo_G474RE_Morpho_Headers/PC7: J2.20
/05_Nucleo_G474RE_Morpho_Headers/PC8: J2.1
/05_Nucleo_G474RE_Morpho_Headers/PC9: J2.2
/05_Nucleo_G474RE_Morpho_Headers/PC10: J1.2
/05_Nucleo_G474RE_Morpho_Headers/PC11: J1.1
/05_Nucleo_G474RE_Morpho_Headers/PC12: J1.4
/05_Nucleo_G474RE_Morpho_Headers/PC13: J1.24
/05_Nucleo_G474RE_Morpho_Headers/PC14: J1.26
/05_Nucleo_G474RE_Morpho_Headers/PC15: J1.28
/05_Nucleo_G474RE_Morpho_Headers/PD2: J1.3
/05_Nucleo_G474RE_Morpho_Headers/PF0: J1.30
/05_Nucleo_G474RE_Morpho_Headers/PF1: J1.32
/05_Nucleo_G474RE_Morpho_Headers/U5V: J2.7
/05_Nucleo_G474RE_Morpho_Headers/VBAT: J1.34
/05_Nucleo_G474RE_Morpho_Headers/VDD_MCU: J1.6
/05_Nucleo_G474RE_Morpho_Headers/VIN_RAW: J1.23
GND: J1.7, J1.19, J1.20, J1.21, J2.10, J2.19, J2.31; also elsewhere on the board

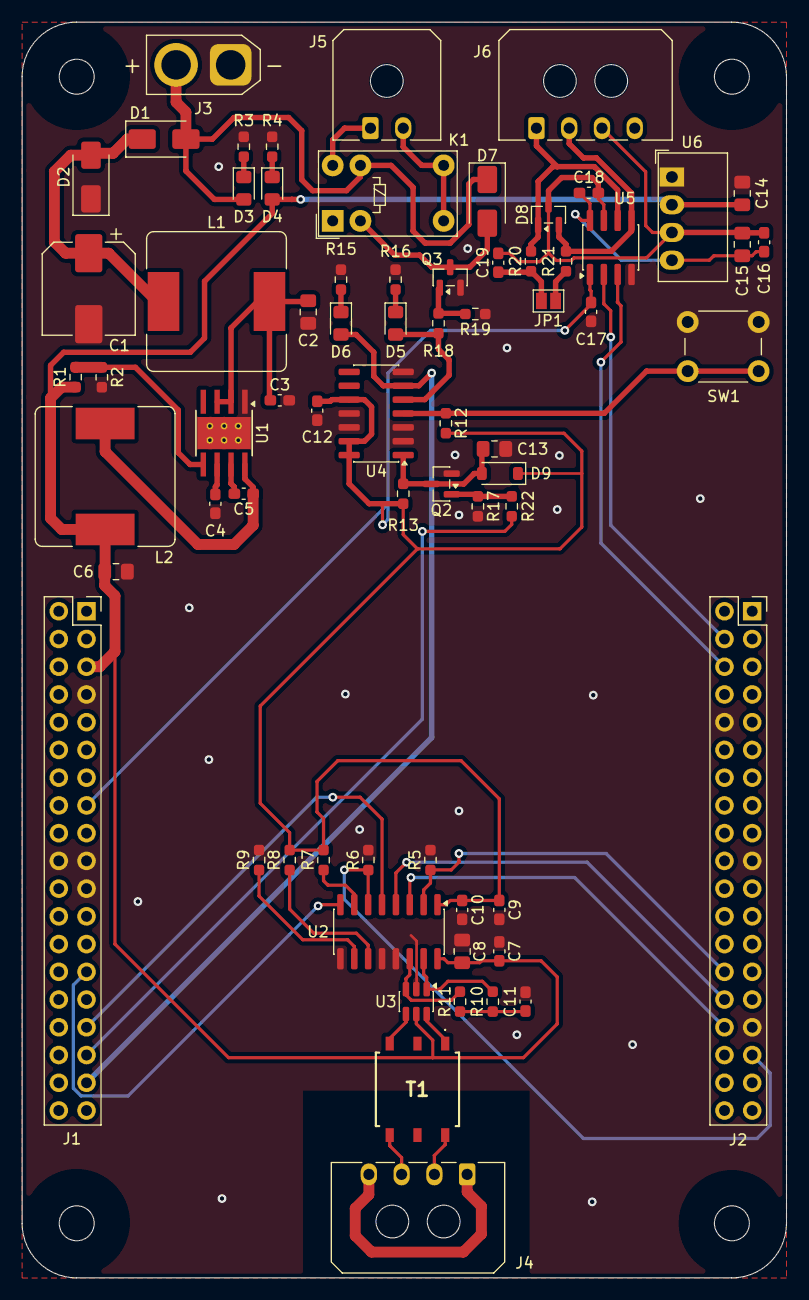
[picture p17: board bms_carrier_shield.kicad_pcb from above]

Board: 4 copper layers, 70.0 x 115.0 mm, 73 parts (0 on the bottom side), 49 nets.
