gabrielfbdiniz/BMS-Master-STM32-Nucleo-G474RE/(commit log)

2026-10-24 feat: initial commit - BMS Master STM32 V0 (Hardware, Firmware, Docs)
    [01_power_supply.kicad_sch, 02_isospi_barrier.kicad_sch, 03_sdc_latch.kicad_sch, 05_canfd_interface.kicad_sch, 06_nucleo_headers.kicad_sch, bms_carrier_shield.kicad_pcb, bms_carrier_shield.kicad_sch, sil_telemetry_log.csv]
2026-10-24 Revise README for STM32 Nucleo G474RE V0
    Updated project name and section headers in README.
2026-10-24 chore: clean up repo root artifacts and showcase carrier board renders in README
    [sil_telemetry_log.csv]
2026-10-24 feat(hardware): generate manufacturing package (Gerbers, Drill, CPL, BOM, and Fab Notes)
    [BMS_Carrier_Shield_BOM_Detailed.csv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]
2026-10-24 feat(hardware): add Mouser BOM tool import files (CSV, TSV, Quick Paste)
    [Mouser_BOM_BMS_Carrier_Shield.csv, Mouser_BOM_Direct_Paste.tsv]
2026-11-01 refactor(repo): standardize project structure, update schematic pdf, fabrication files and 3d renders
    [01_power_supply.kicad_sch, 02_isospi_barrier.kicad_sch, 03_sdc_latch.kicad_sch, 06_nucleo_headers.kicad_sch, BMS_Carrier_Shield_BOM_Detailed.csv, Mouser_BOM_BMS_Carrier_Shield.csv, Mouser_BOM_Direct_Paste.tsv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]
